rascho2/reaction-time-game/docs/images/results.jpg

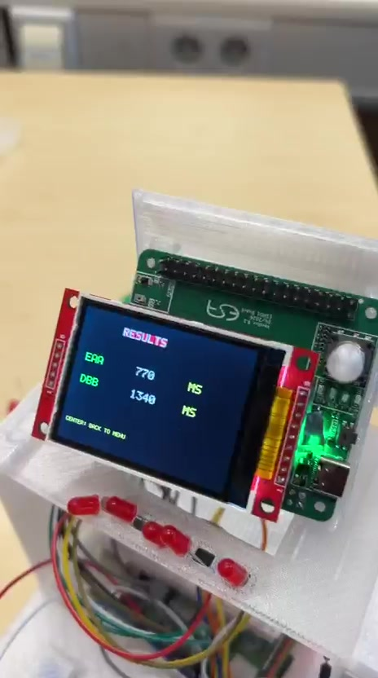
docs/images/results.jpg
