rascho2/reaction-time-game/docs/images/console.jpg

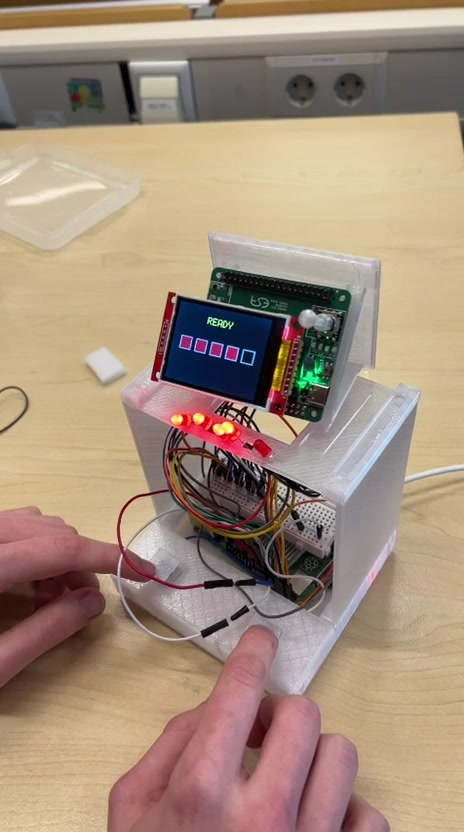
docs/images/console.jpg
