rascho2/reaction-time-game/cad/bottom_housing.stl

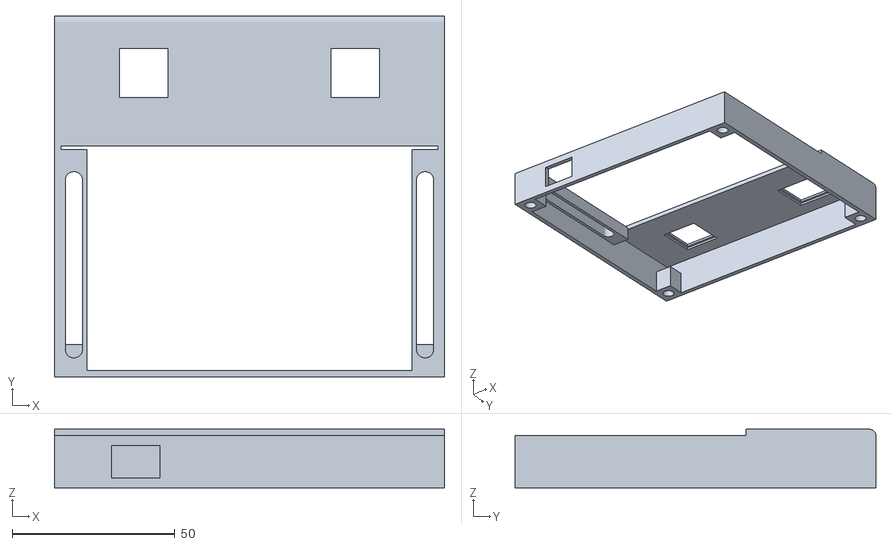
[picture p3: CAD file, 2026-10-08]
cad/bottom_housing.stl
120.0 x 111.0 x 18.0
