rascho2/reaction-time-game/cad/extension_board_frame.stl

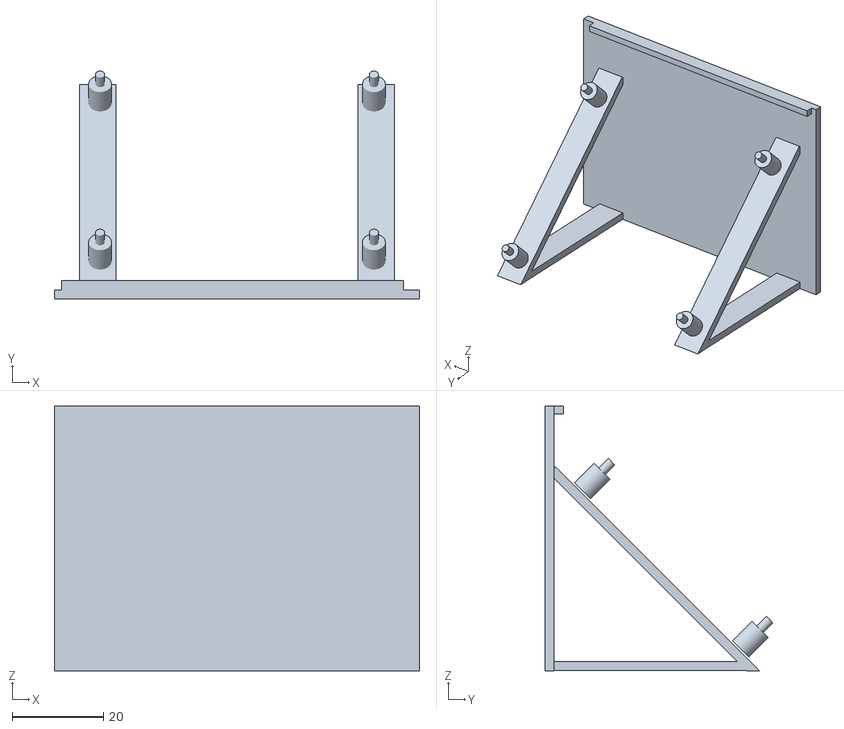
[picture p4: CAD file, 2026-10-08]
cad/extension_board_frame.stl
80.0 x 49.9 x 58.0
