rascho2/reaction-time-game/cad/top_housing_wall.stl

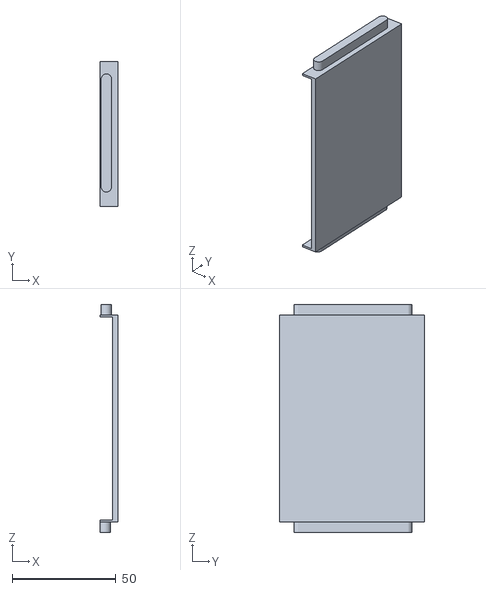
[picture p5: CAD file, 2026-10-08]
cad/top_housing_wall.stl
8.50 x 70.0 x 110.0
