rascho2/reaction-time-game/cad/top_housing_plate.stl

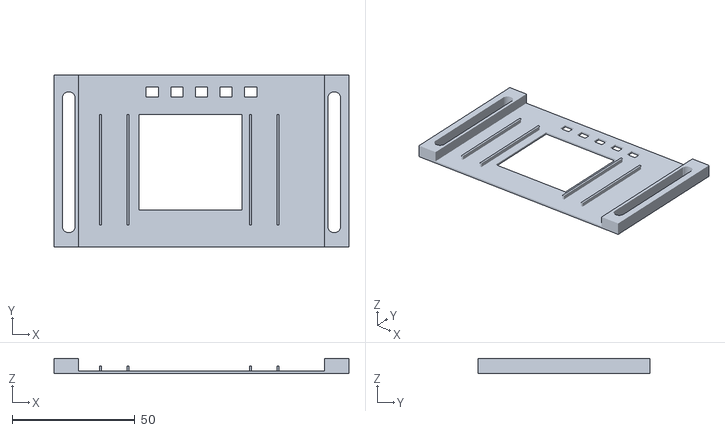
[picture p6: CAD file, 2026-10-08]
cad/top_housing_plate.stl
120.0 x 70.0 x 6.00
