rascho2/reaction-time-game/cad/switch_mounting_plate.stl

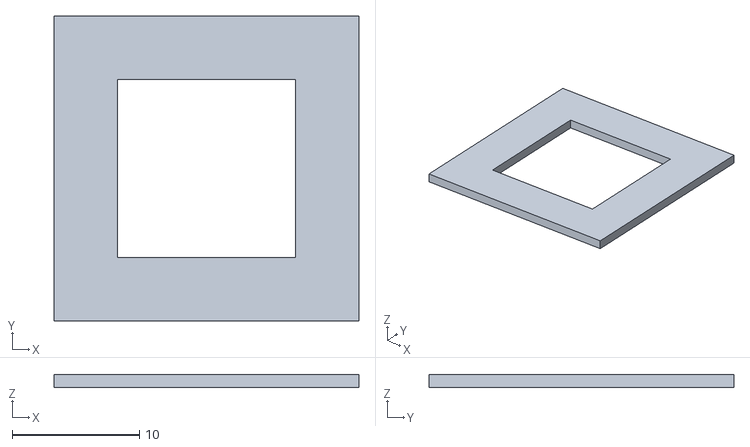
[picture p7: CAD file, 2026-10-08]
cad/switch_mounting_plate.stl
24.0 x 24.0 x 1.00
