rascho2/reaction-time-game/cad/bottom_plate_with_pi_standoffs.stl

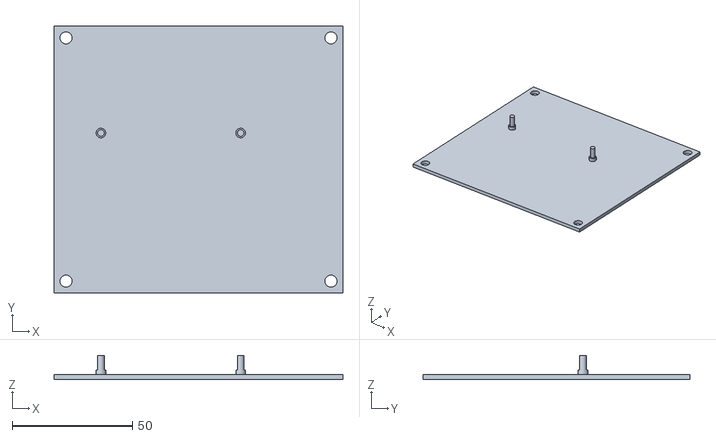
[picture p8: CAD file, 2026-10-08]
cad/bottom_plate_with_pi_standoffs.stl
120.0 x 111.0 x 10.0
