rascho2/reaction-time-game/cad/switch_keycap.stl

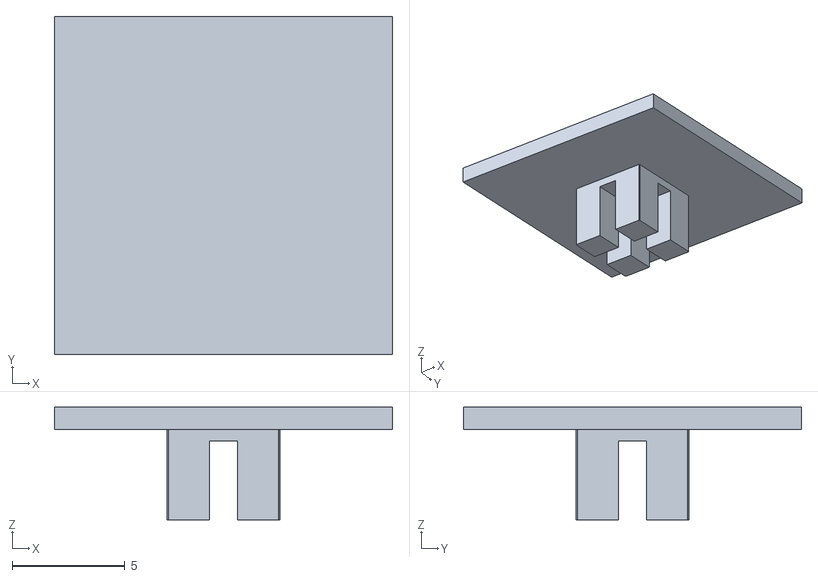
[picture p9: CAD file, 2026-10-08]
cad/switch_keycap.stl
15.0 x 15.0 x 5.00
