rascho2/reaction-time-game/cad/foot.stl

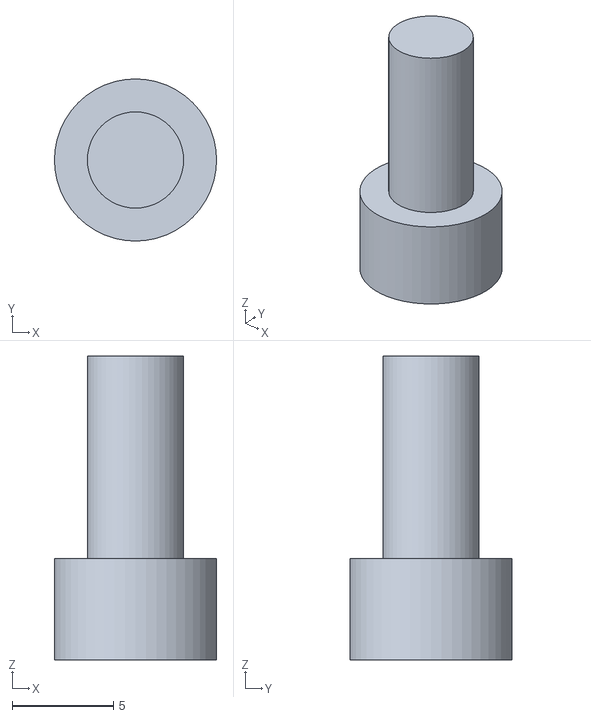
[picture p10: CAD file, 2026-10-08]
cad/foot.stl
8.00 x 8.00 x 15.0
