rascho2/reaction-time-game/cad/Extension_board_mount.stl

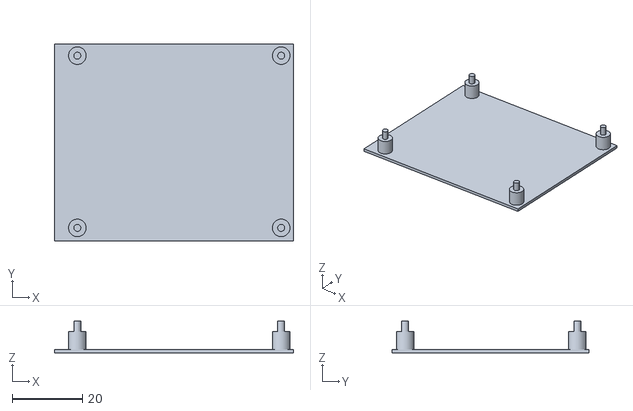
[picture p11: CAD file, 2026-10-08]
cad/Extension_board_mount.stl
68.0 x 56.0 x 9.00
